Timothy-ZhangYF/ESE-5160/EC_MCAD.md

# EC_MCAD

```comment
Team Number: 09
Team Name: Shorts & Sparks
Team Members: James Steeman and Timothy Zhang
GitHub Repository URL: https://github.com/ese5160/final-project-t09-shorts-sparks
Description of test hardware: MacBook Pro M2 (MacOS), RPL, PML, Metal parts, acrylic sheets
```

## Original Project CAD

CAD for the 3 axis cnc machine: mostly complete (not finished due to project change)

[3 axis cnc onshape](https://cad.onshape.com/documents/9ba5abc5de17df0d5401db27/w/24cade721c0acaf69a67cd1f/e/fe2a9c92b757dd225e4ea1f8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)

### MCAD image

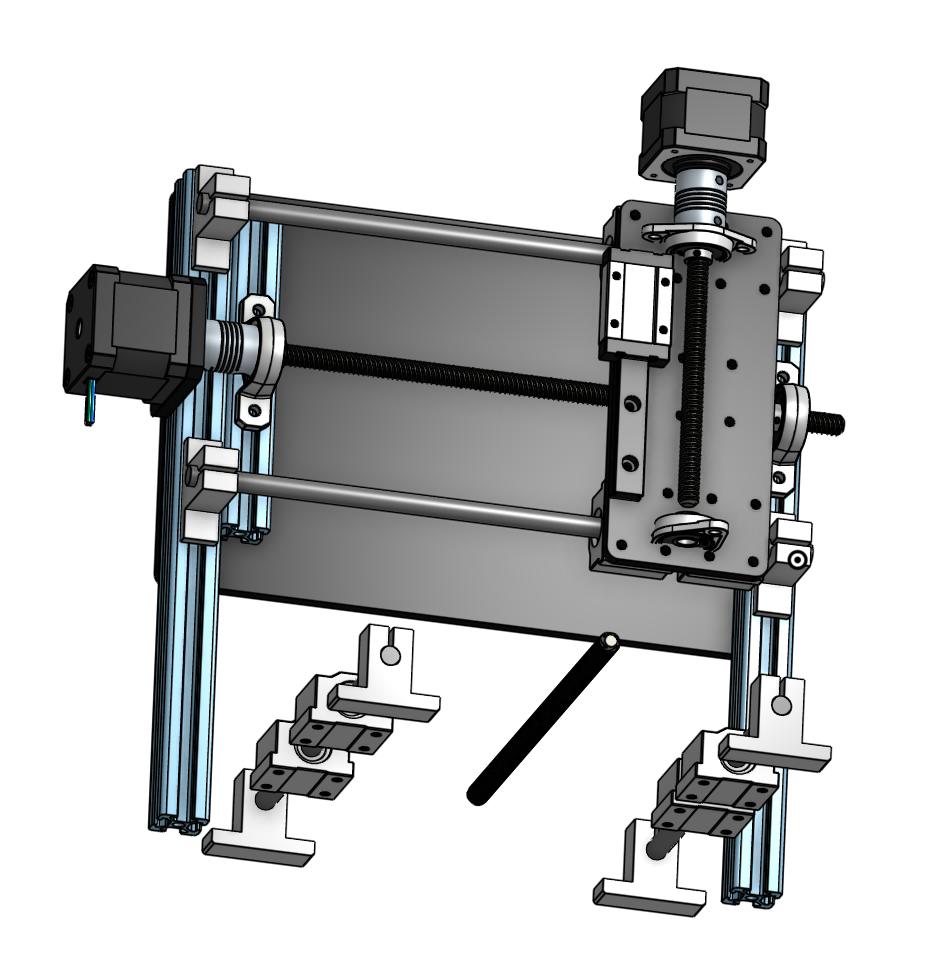
[picture p1: Final Project Work/CAD/mCAD/CNC_MCAD.png]


### IRL images/prototyping



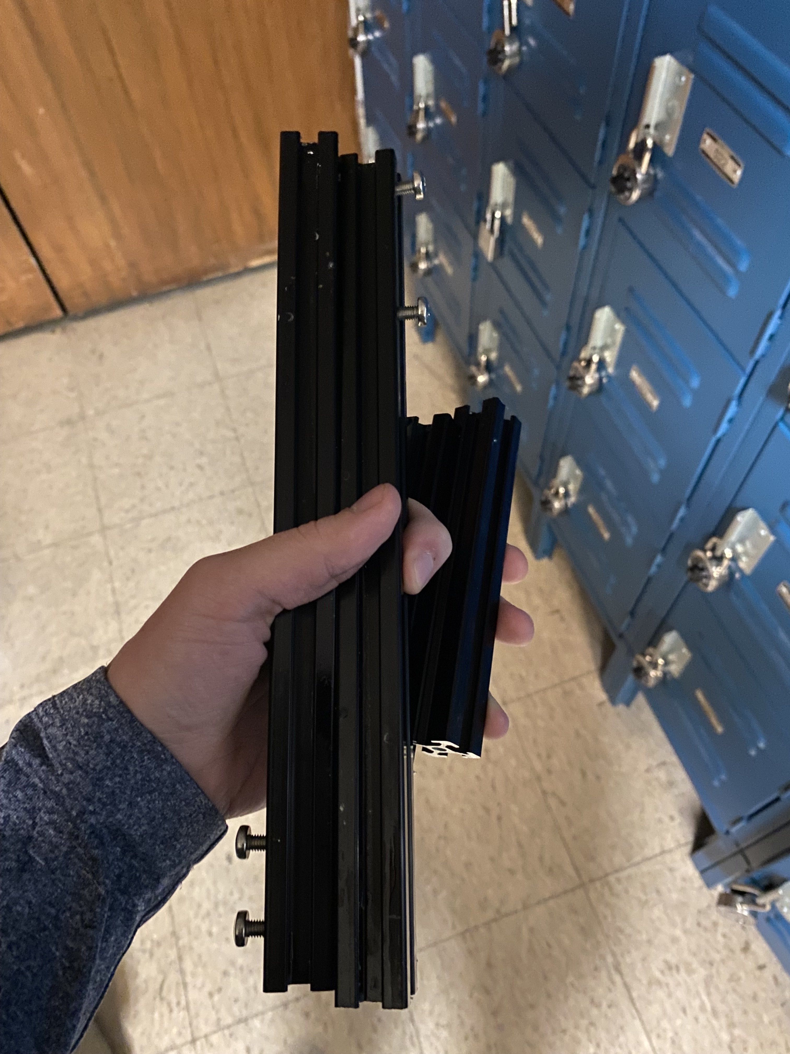
[picture p2: Final Project Work/CAD/Mechanical Demo/Cut_Pieces.jpg]


<video controls src="Final Project Work/CAD/Mechanical Demo/One_axis_assembly.MOV" title="Title"></video>

## Gyroscopic Boat Stabilizer CAD

Completed CAD for the gyroscopic boat stabilizer (built for demo day project)

[Gyroscopic boat stabilizer onshape](https://cad.onshape.com/documents/508738bfe83f32f7e9bd0fc0/w/ed6beb4e7e96504ac79d305c/e/c253c293fa2ddf3ee9321355)

### MCAD Images

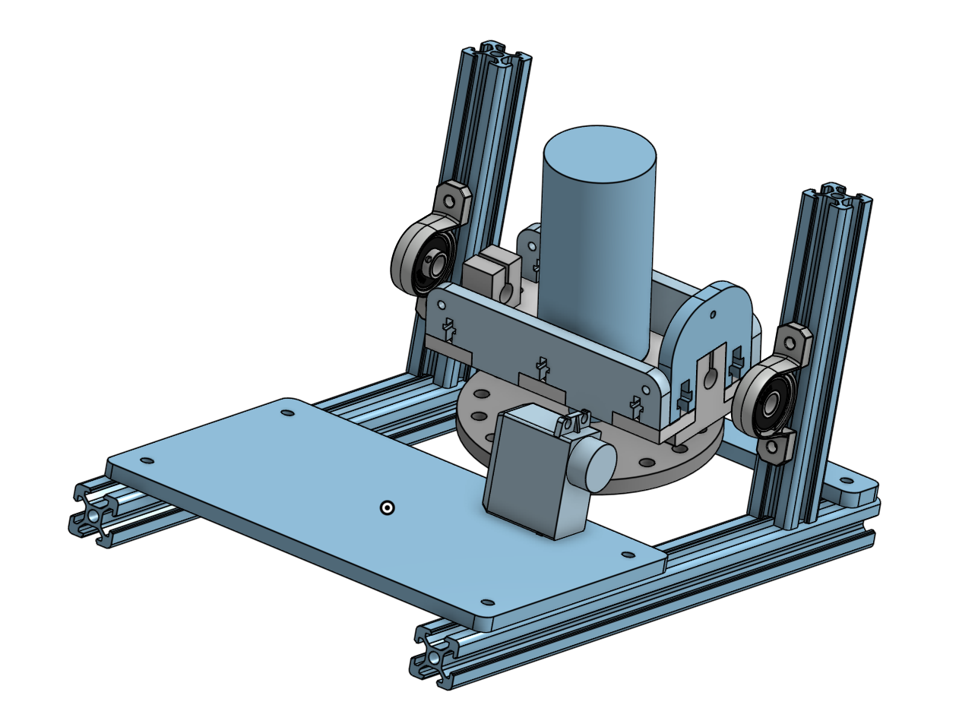
[picture p3: Final Project Work/CAD/mCAD/GRYO_MCAD.png]


### IRL gyro

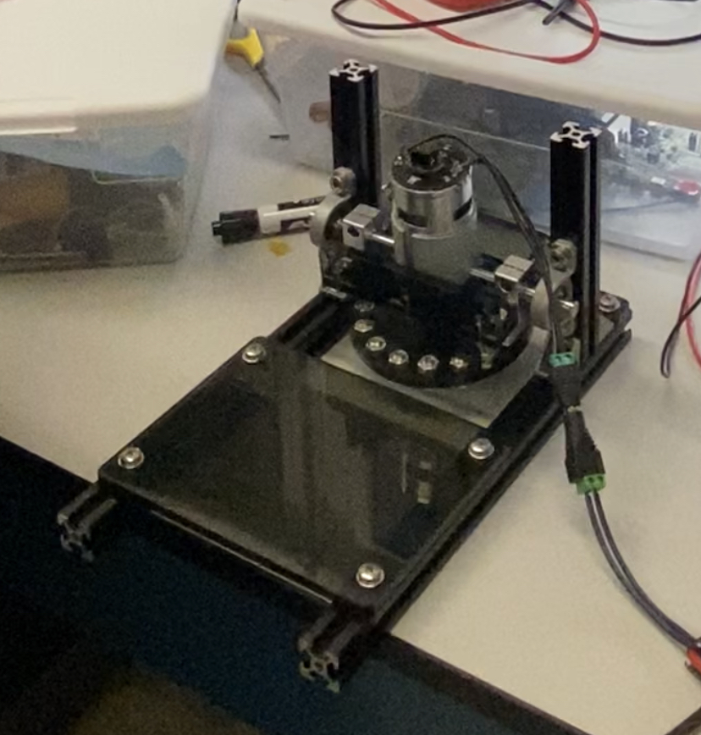
[picture p4: Final Project Work/CAD/mCAD/GYRO_IRL.jpeg]
