Timothy-ZhangYF/ESE-5160/Final Project Work/SAMW25 - Brain - Code/Atmel_start/ATMEL_START_5160_FINAL/ATMEL_START_5160_FINAL/documentation/get_weather.rst

================
Get Weather Demo
================

This example demonstrates the use of the ATWINC1500 with the supported Xplained Pro boards 
mentioned below to how to run the Get Weather Client Demo application.

Hardware Support
----------------
* SAMD21 Xplained Pro
* SAMD51 Custom Board
* SAME54 Xplained Pro
* SAME70 Xplained Pro
* SAMG53 Xplained Pro
* SAMG55 Xplained Pro
* SAML21 Xplained Pro
* SAML22 Xplained Pro
* SAMV71 Xplained Ultra
* ATWINC1500 on EXT1 header
* ATWINC1500 on EXT2 header(Only for SAME70 and SAMV71 Xplained Pro)

Demo Procedure
--------------
Refer the WINC1500 software Programming Guide for more details.

http://ww1.microchip.com/downloads/en/devicedoc/atmel-42418-software-programming-guide-for-atwinc1500-wifi-using-samd21-xplained-pro_userguide.pdf
