Timothy-ZhangYF/ESE-5160/Final Project Work/CAD/mCAD/Z_axis_base_plate.SLDPRT

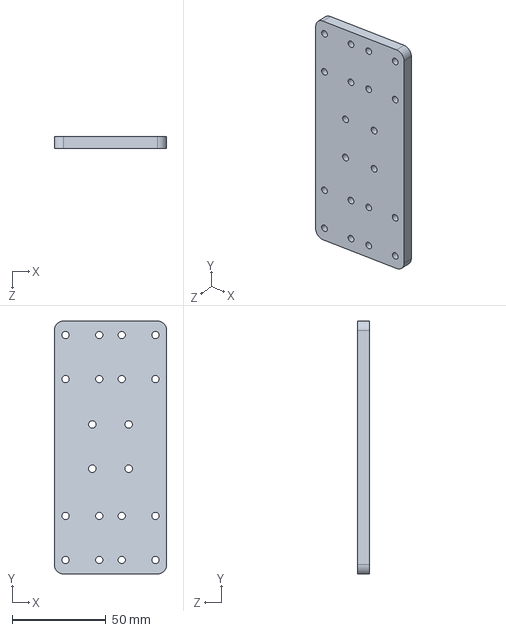
[picture p6: CAD file, 2026-08-19]
Final Project Work/CAD/mCAD/Z_axis_base_plate.SLDPRT
60.0 x 135.0 x 6.35 mm
