Timothy-ZhangYF/ESE-5160/Final Project Work/CAD/mCAD/aluminum2020.SLDPRT

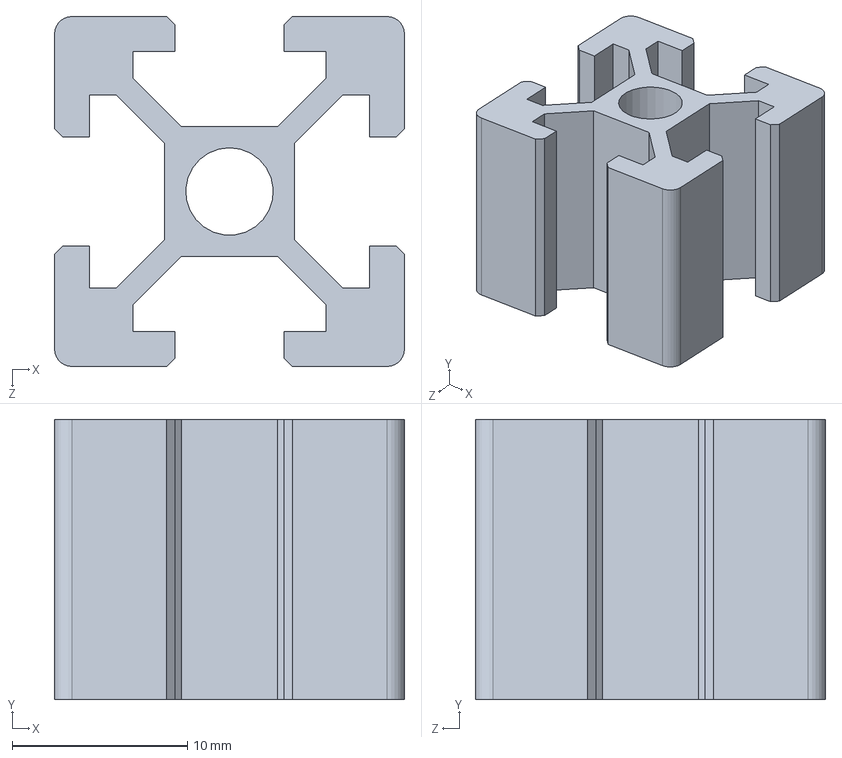
[picture p7: CAD file, 2026-08-19]
Final Project Work/CAD/mCAD/aluminum2020.SLDPRT
20.0 x 16.0 x 20.0 mm
