Timothy-ZhangYF/ESE-5160/(list of files, cad)

Other CAD files:
Final Project Work/CAD/mCAD/Gantry_Backplate.SLDPRT
