Timothy-ZhangYF/ESE-5160/Final Project Work/Board Bringup Images/PCB Images/Assembled1.jpg

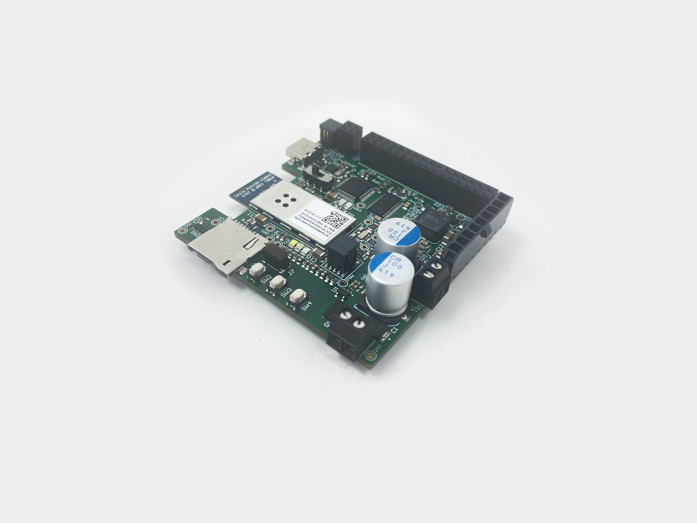
Final Project Work/Board Bringup Images/PCB Images/Assembled1.jpg
