Timothy-ZhangYF/ESE-5160/Final Project Work/Board Bringup Images/PCB Images/Assembled&Tested.jpg

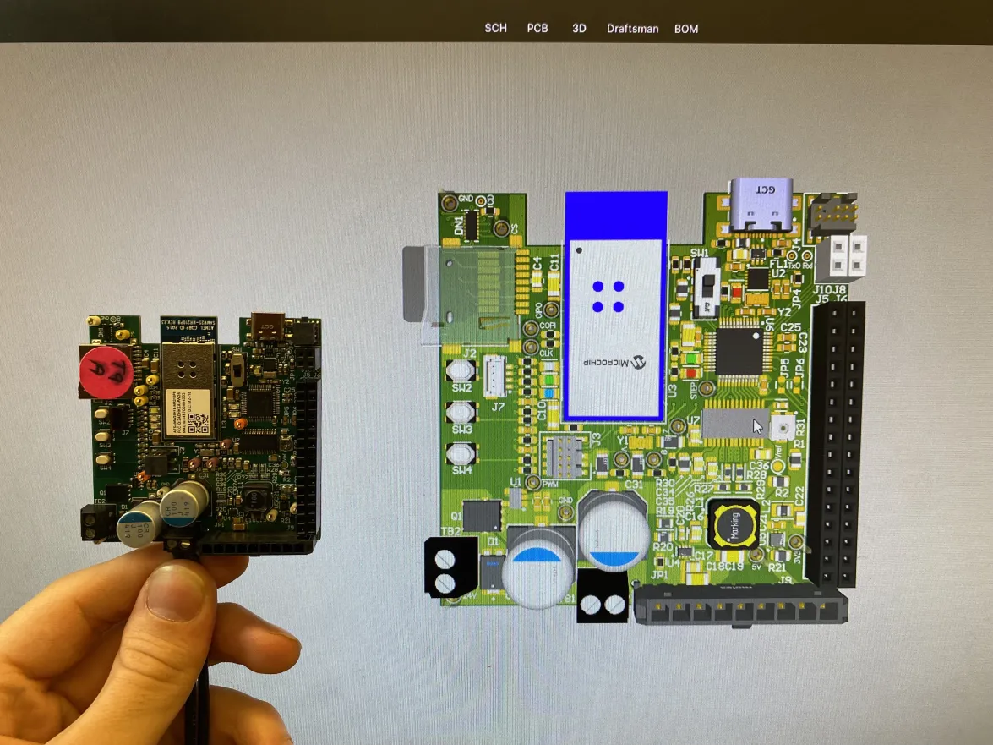
Final Project Work/Board Bringup Images/PCB Images/Assembled&Tested.jpg
