Timothy-ZhangYF/ESE-5160/Final Project Work/SAMD21 - Closed Loop Stepper Module - Code/SAMD21_PWM_STEP.png

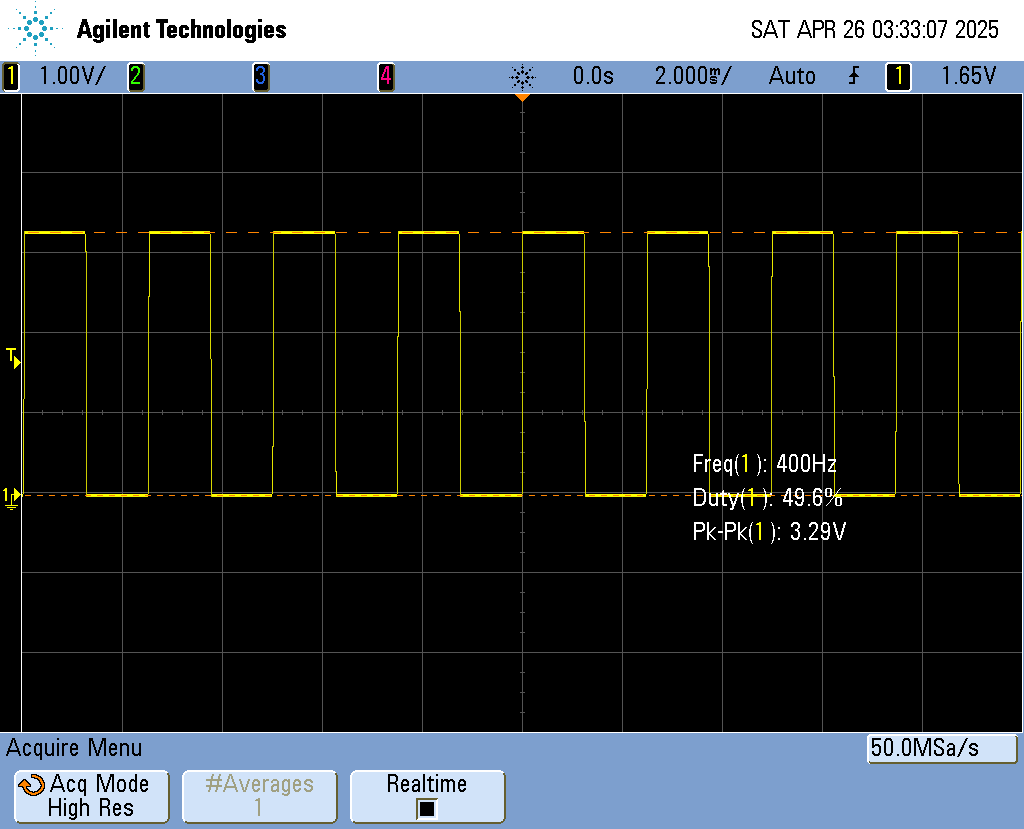
Final Project Work/SAMD21 - Closed Loop Stepper Module - Code/SAMD21_PWM_STEP.png
