Timothy-ZhangYF/ESE-5160/Final Project Work/Integration Testing/vidoes.md

# videos.md

This file contains links to testing videos in drive

## Node Red DC motor control

[Drive Link to video](https://drive.google.com/file/d/14GuaIPsj_WVFC27XR5ruW5WhOnH9_ush/view?usp=sharing)

Shows setting speed and ramping to speed based on node red inputs. Shows both cli print statments of set speeds and current values (duty cycle variable) as ramping occurs, and the actual motor rpm changing (board is attached to the mechanical system)
