Timothy-ZhangYF/ESE-5160/Final Project Work/Board Bringup Images/DC Motor Power Evaluation/DC_motor_drive_video_links.md

# DC motor google drive video links

[Short 10 percent video](https://drive.google.com/file/d/1YR15FuntN2rYiW8-UY3sy5oZE_7e29Wv/view?usp=sharing)

[Longer increasing percentage video](https://drive.google.com/file/d/11h0DyglUkyiTILQowORXFs8HXTB2xmya/view?usp=sharing)
