Timothy-ZhangYF/ESE-5160/Final Project Work/Board Bringup Images/DC Motor Power Evaluation/3V3in_Gate_Drive_IC_4A_Eload.jpg

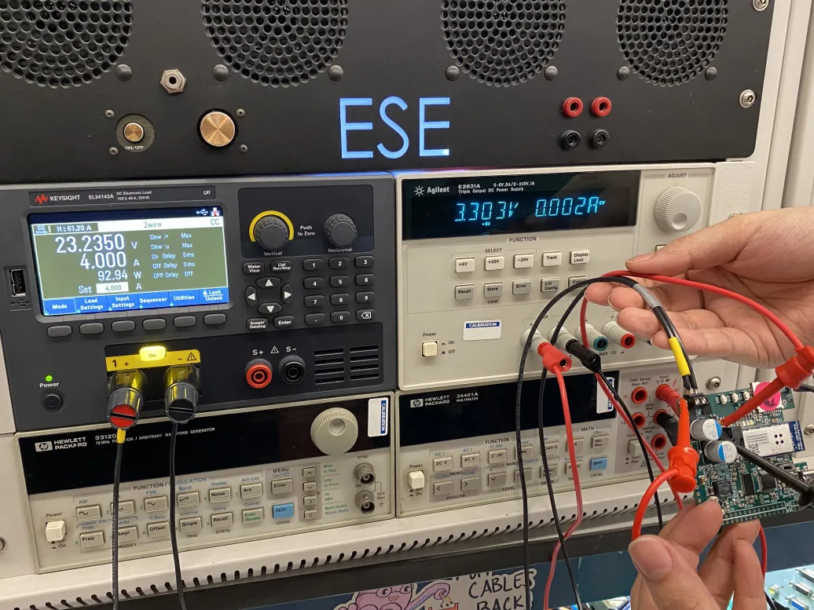
Final Project Work/Board Bringup Images/DC Motor Power Evaluation/3V3in_Gate_Drive_IC_4A_Eload.jpg
