Timothy-ZhangYF/ESE-5160/Final Project Work/Board Bringup Images/DC Motor Power Evaluation/10k_wavgen_square_Eload_2A.jpg

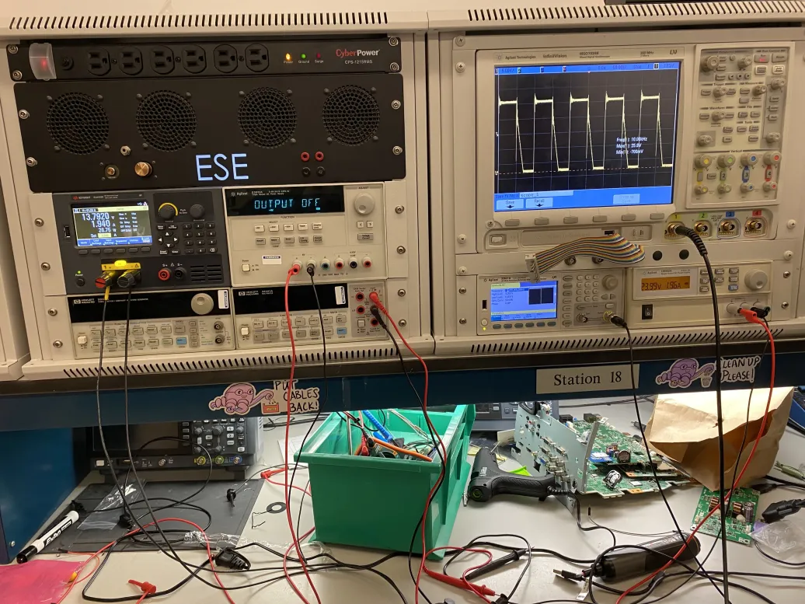
Final Project Work/Board Bringup Images/DC Motor Power Evaluation/10k_wavgen_square_Eload_2A.jpg
