Timothy-ZhangYF/ESE-5160/Final Project Work/Board Bringup Images/DC Motor Power Evaluation/Across_eload_terminals.png

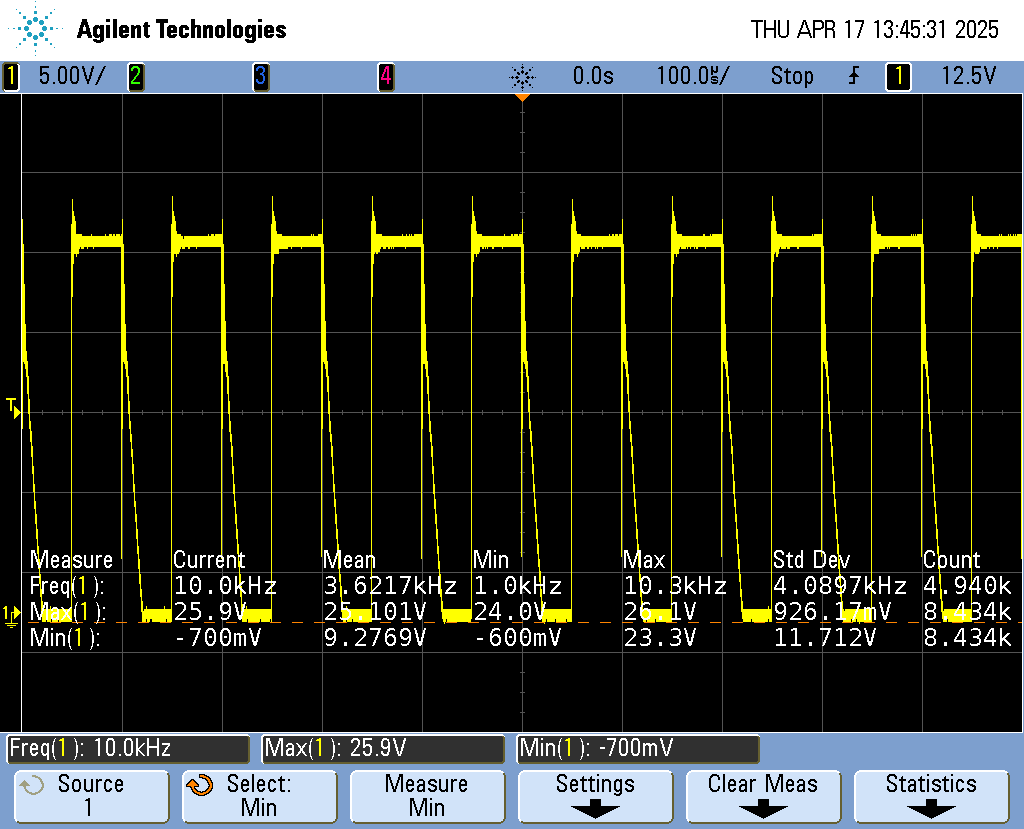
Final Project Work/Board Bringup Images/DC Motor Power Evaluation/Across_eload_terminals.png
