Timothy-ZhangYF/ESE-5160/Final Project Work/Board Bringup Images/DC Motor Power Evaluation/Gate_Drive_IC_3V3in.jpg

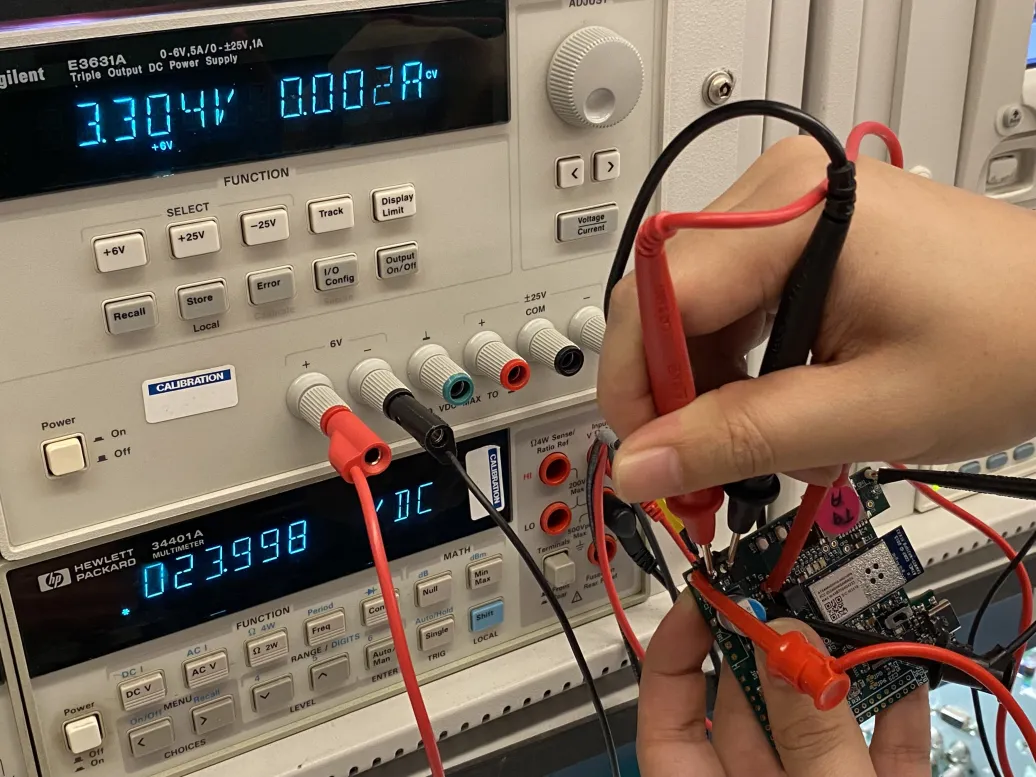
Final Project Work/Board Bringup Images/DC Motor Power Evaluation/Gate_Drive_IC_3V3in.jpg
