Timothy-ZhangYF/ESE-5160/Final Project Work/Board Bringup Images/DC Motor Power Evaluation/Gate_Drive_IC_Pull_Down_Functional.jpg

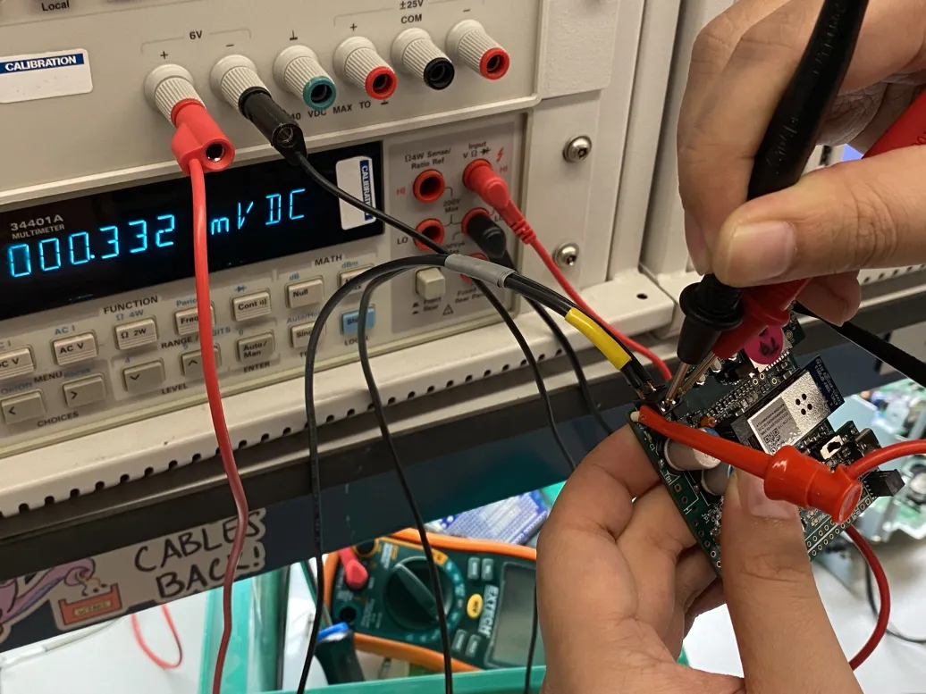
Final Project Work/Board Bringup Images/DC Motor Power Evaluation/Gate_Drive_IC_Pull_Down_Functional.jpg
