Timothy-ZhangYF/ESE-5160/Final Project Work/Board Bringup Images/PCB Images/No_ThruHole2.jpg

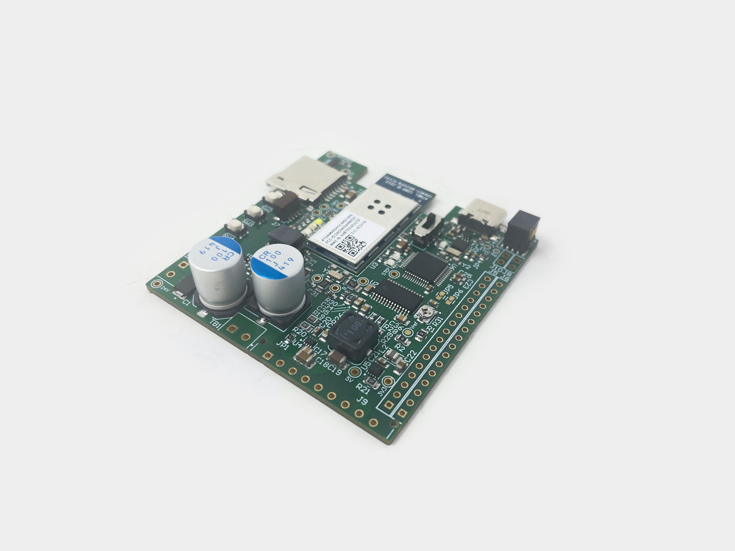
Final Project Work/Board Bringup Images/PCB Images/No_ThruHole2.jpg
