Timothy-ZhangYF/ESE-5160/Final Project Work/Board Bringup Images/PCB Images/Thermal_Camera_PCB.jpeg

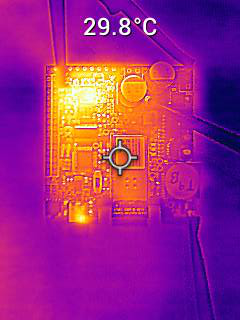
Final Project Work/Board Bringup Images/PCB Images/Thermal_Camera_PCB.jpeg
