Timothy-ZhangYF/ESE-5160/Final Project Work/Board Bringup Images/PCB Images/Top_View.jpg

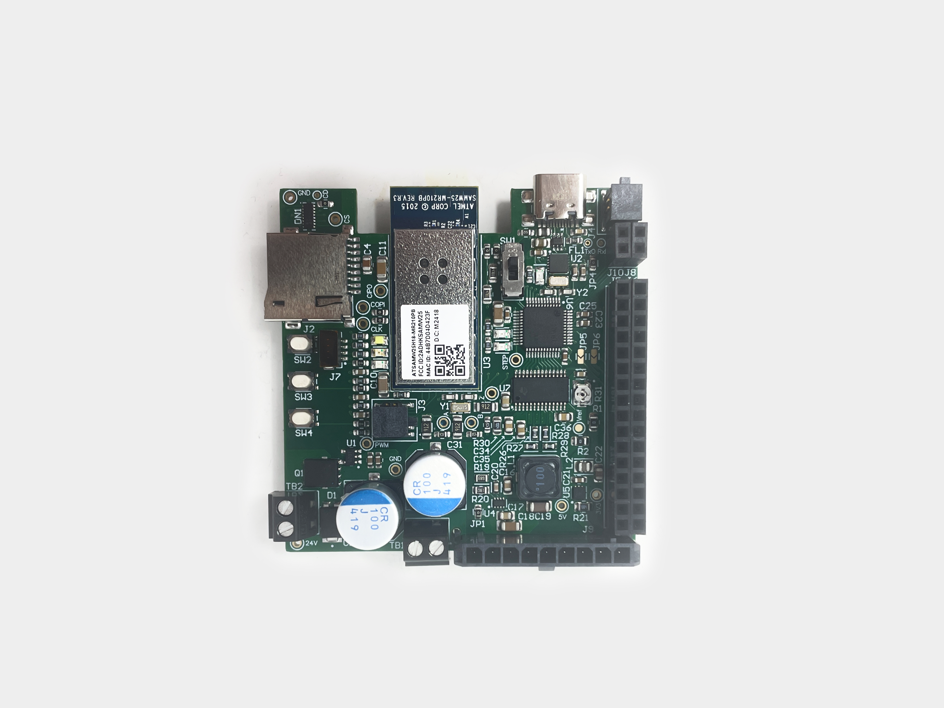
Final Project Work/Board Bringup Images/PCB Images/Top_View.jpg
