Timothy-ZhangYF/ESE-5160/Final Project Work/Board Bringup Images/Power Regulation Evaluation/3V3_Buck_transient.png

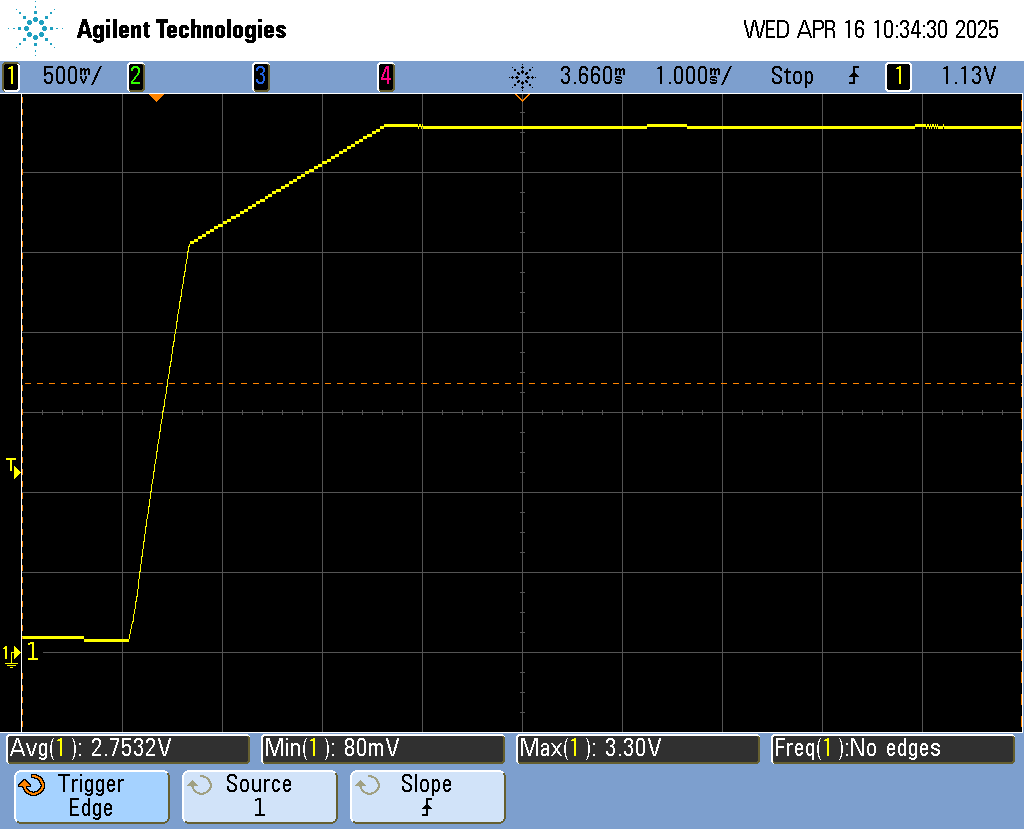
Final Project Work/Board Bringup Images/Power Regulation Evaluation/3V3_Buck_transient.png
