Timothy-ZhangYF/ESE-5160/Final Project Work/Board Bringup Images/Power Regulation Evaluation/5V_Buck_steady_state1.png

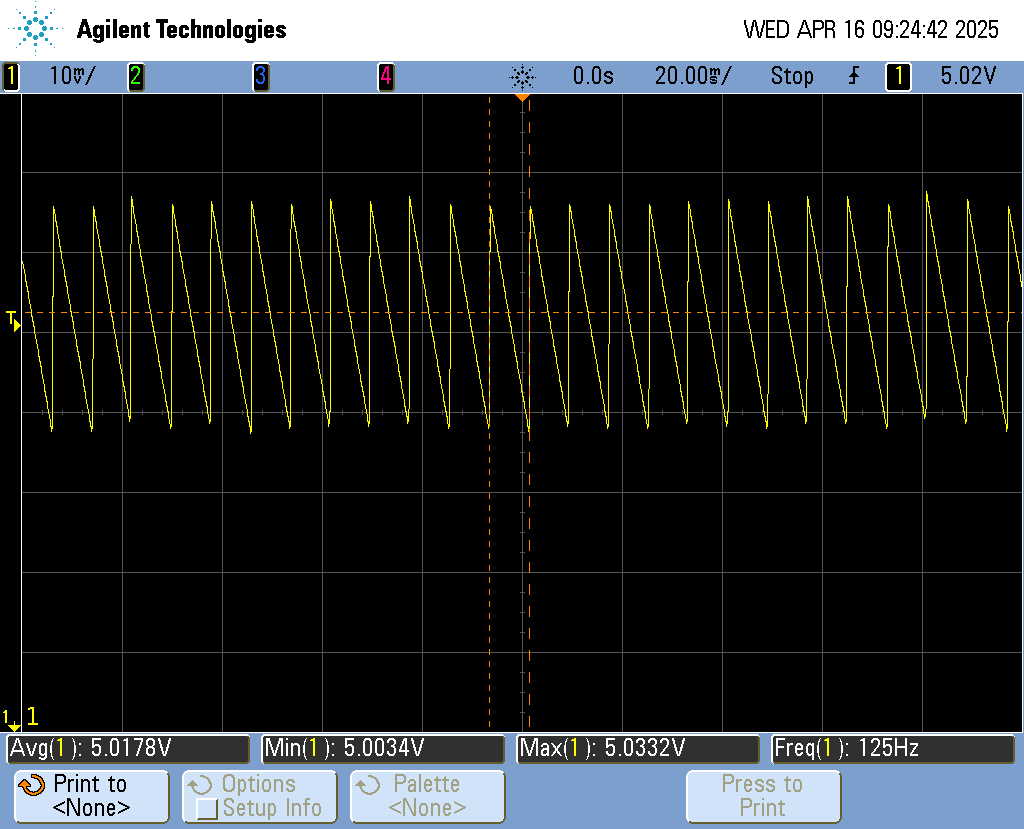
Final Project Work/Board Bringup Images/Power Regulation Evaluation/5V_Buck_steady_state1.png
