Timothy-ZhangYF/ESE-5160/Final Project Work/Board Bringup Images/Power Regulation Evaluation/5V_Buck_steady_state.png

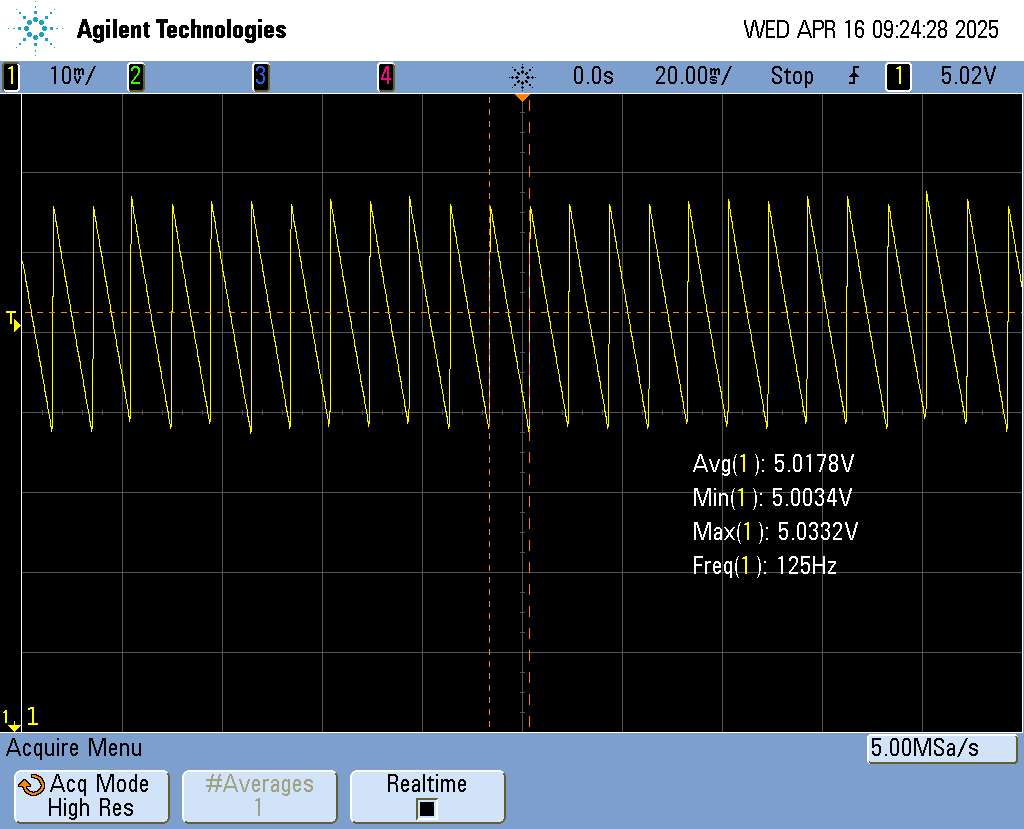
Final Project Work/Board Bringup Images/Power Regulation Evaluation/5V_Buck_steady_state.png
