Timothy-ZhangYF/ESE-5160/Final Project Work/Board Bringup Images/Power Regulation Evaluation/24V_transient1.png

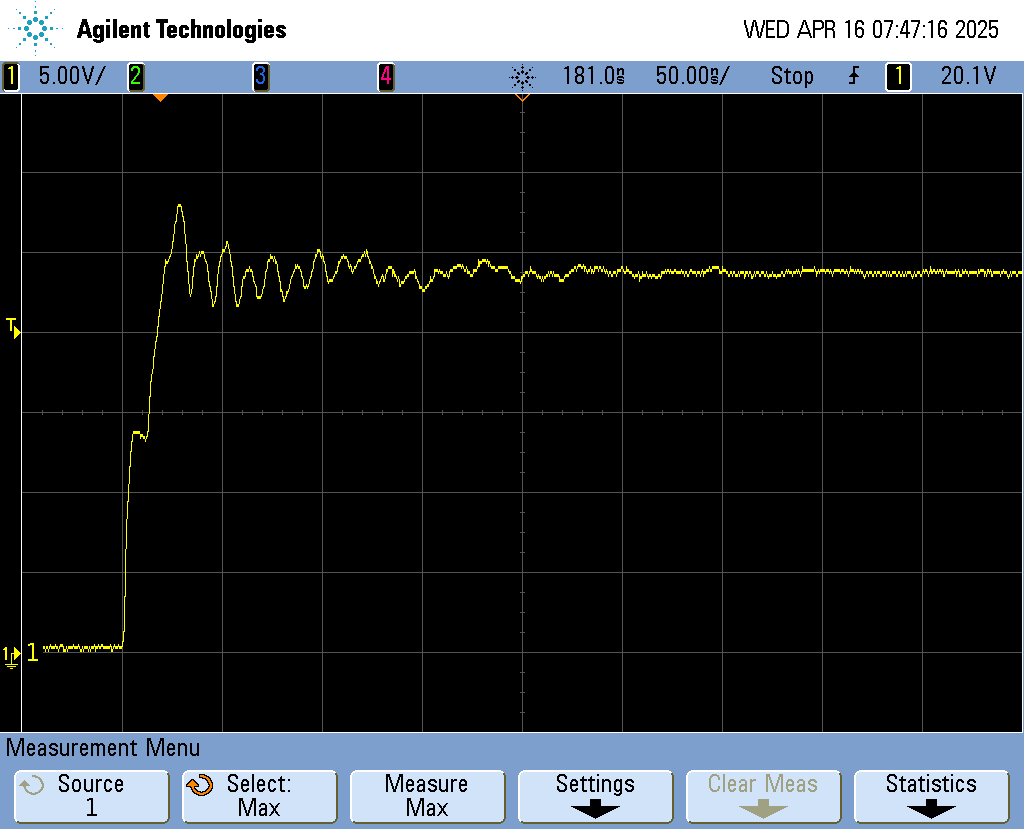
Final Project Work/Board Bringup Images/Power Regulation Evaluation/24V_transient1.png
