Timothy-ZhangYF/ESE-5160/Final Project Work/Board Bringup Images/Power Regulation Evaluation/Both_Bucks_from_24V.png

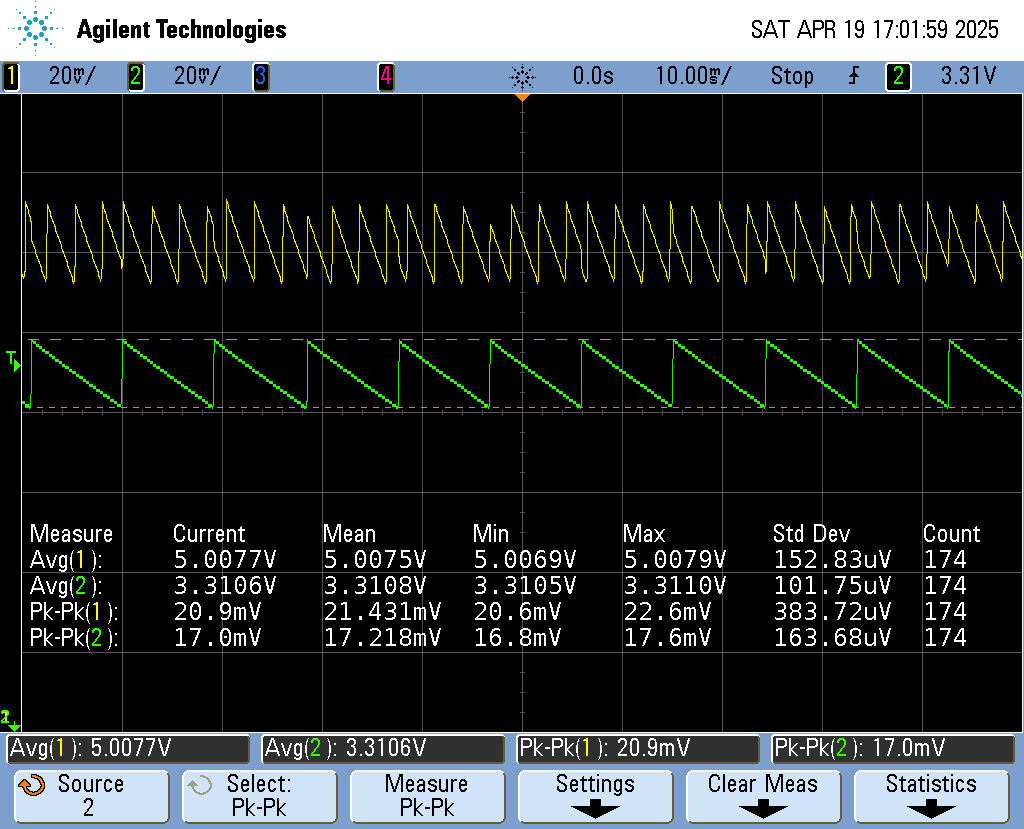
Final Project Work/Board Bringup Images/Power Regulation Evaluation/Both_Bucks_from_24V.png
