Timothy-ZhangYF/ESE-5160/Final Project Work/Board Bringup Images/Power Regulation Evaluation/Load_Test_3V3_Regulator_Critical.jpg

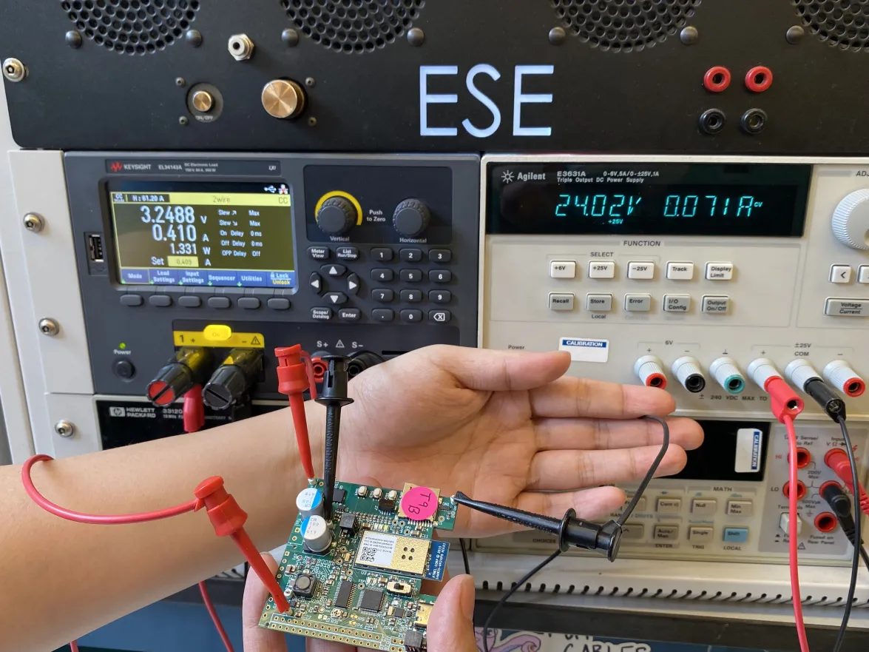
Final Project Work/Board Bringup Images/Power Regulation Evaluation/Load_Test_3V3_Regulator_Critical.jpg
