Timothy-ZhangYF/ESE-5160/Final Project Work/Board Bringup Images/Power Regulation Evaluation/Load_Test_24V_System.jpg

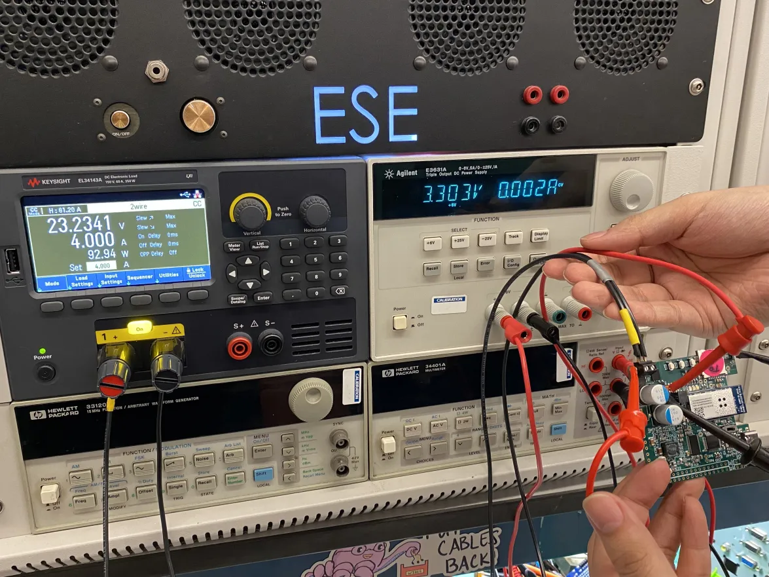
Final Project Work/Board Bringup Images/Power Regulation Evaluation/Load_Test_24V_System.jpg
