Timothy-ZhangYF/ESE-5160/Final Project Work/Board Bringup Images/Power Regulation Evaluation/Power_testpoints.jpg

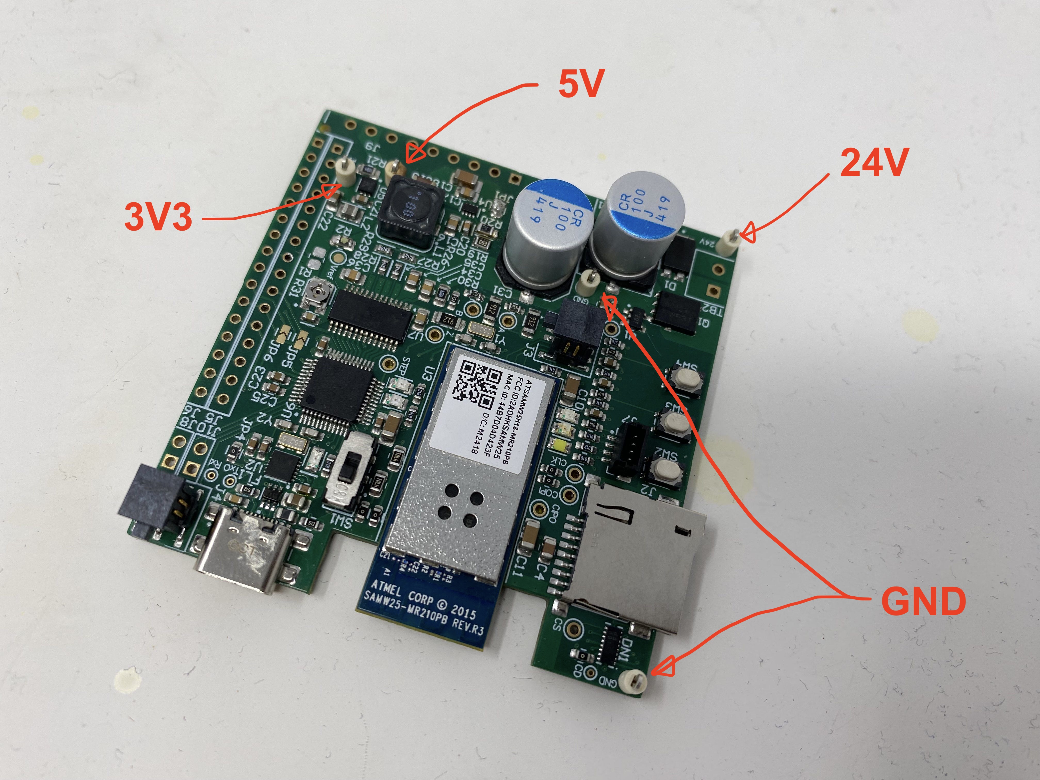
Final Project Work/Board Bringup Images/Power Regulation Evaluation/Power_testpoints.jpg
