Timothy-ZhangYF/ESE-5160/Final Project Work/CAD/Mechanical Demo/Motor_Surgery.JPG

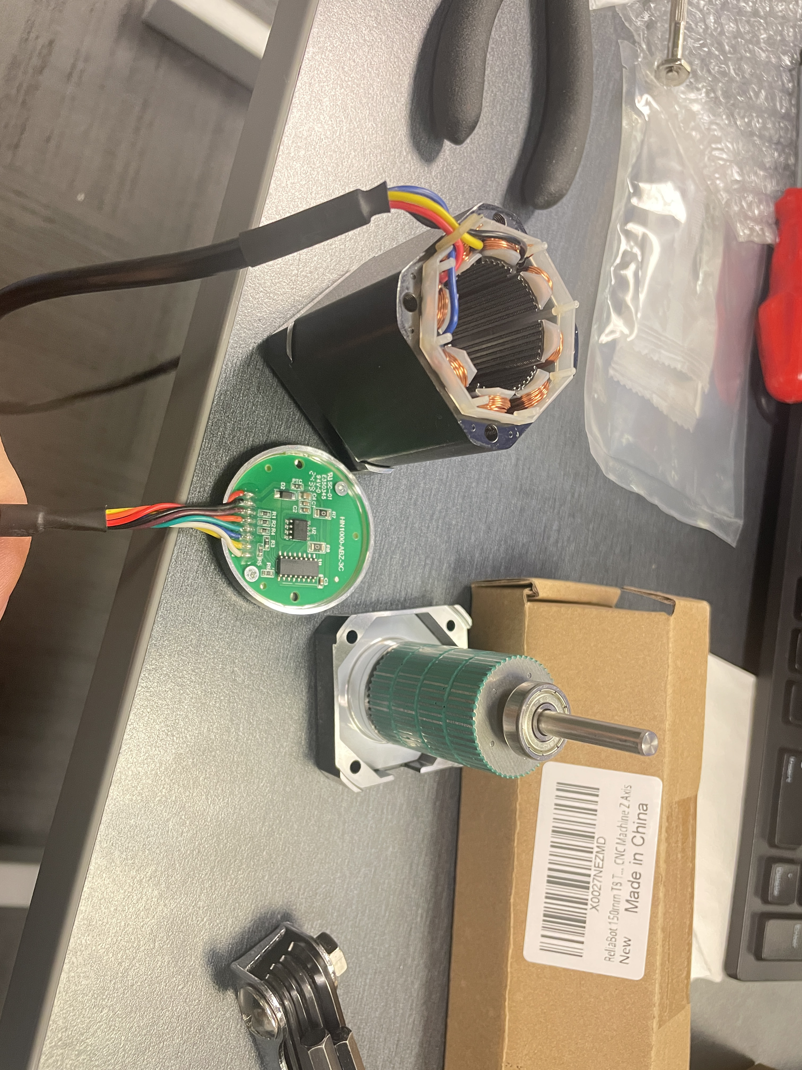
Final Project Work/CAD/Mechanical Demo/Motor_Surgery.JPG
